versioduo/tee/hardware/tee.pdf

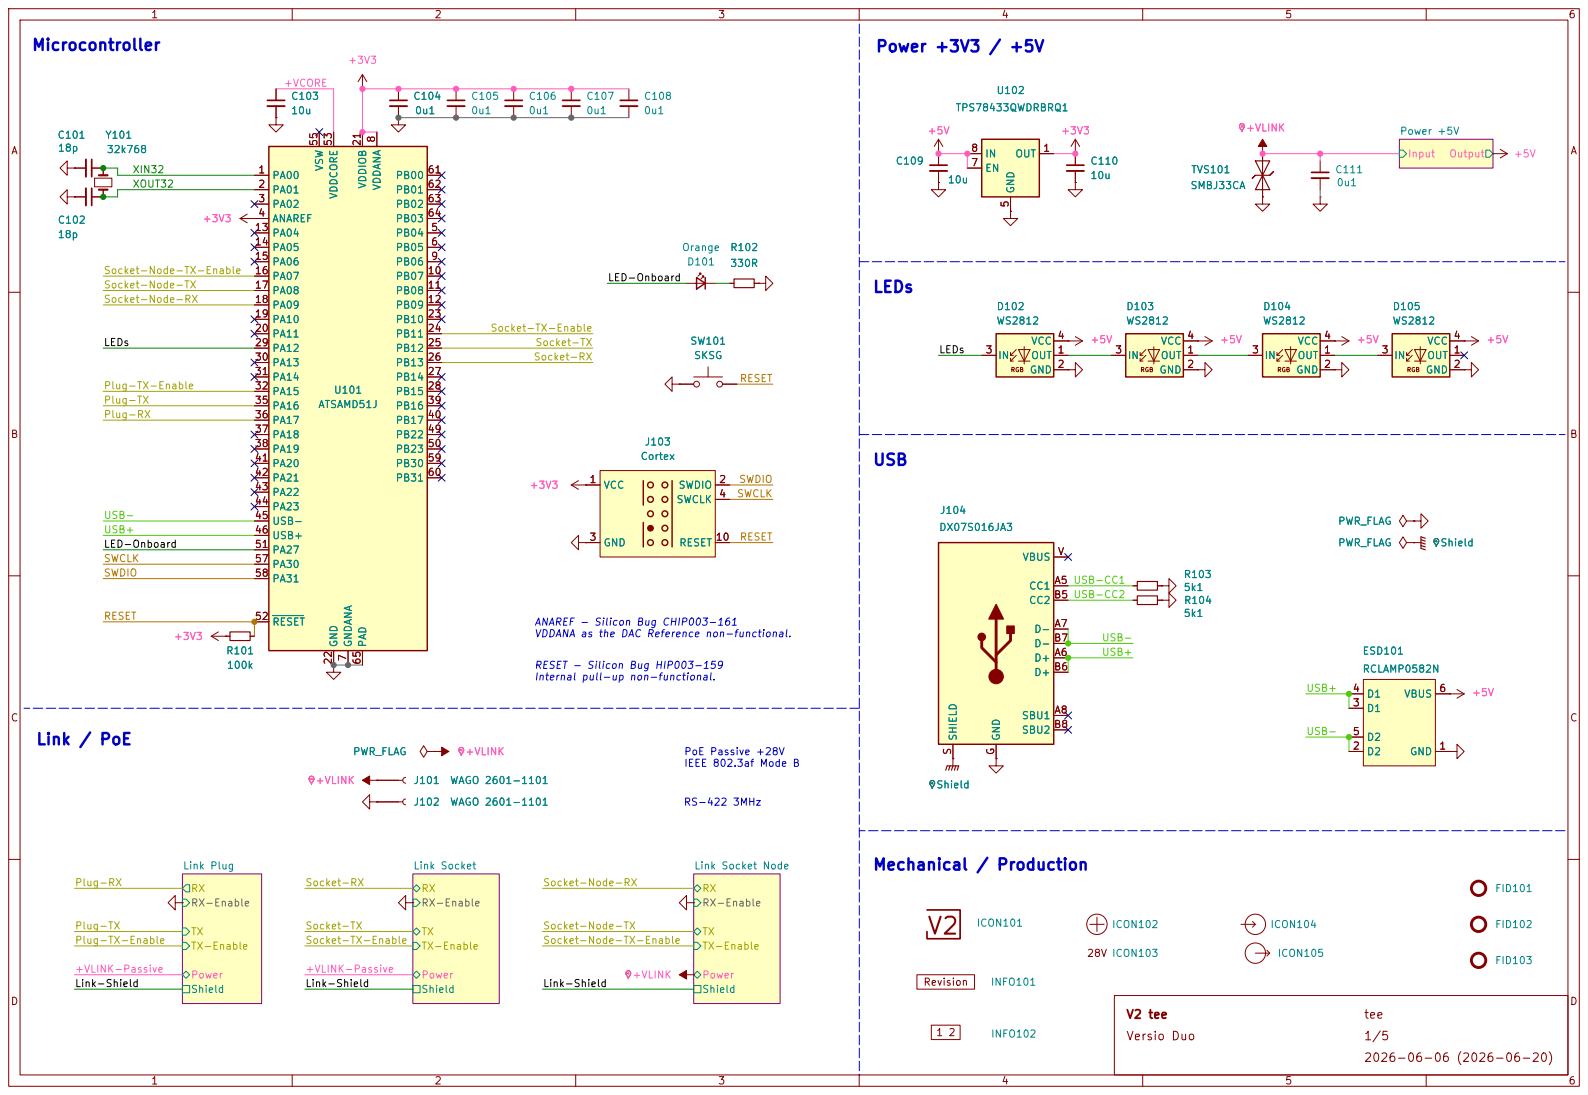
[picture p1: page 1]

Socket-Node-RX
LED-Onboard Plug-TX

LEDs Plug-TX-Enable
LEDs Plug-RX

Socket-Node-RX RESET SWDIO

ANAREF - Silicon Bug CHIP003-161
VDDANA as the DAC Reference non-functional. RESET - Silicon Bug HIP003-159

Internal pull-up non-functional. RS-422 3MHz PoE Passive +28V

TX-Enable Power Shield

Link-Shield +VLINK-Passive

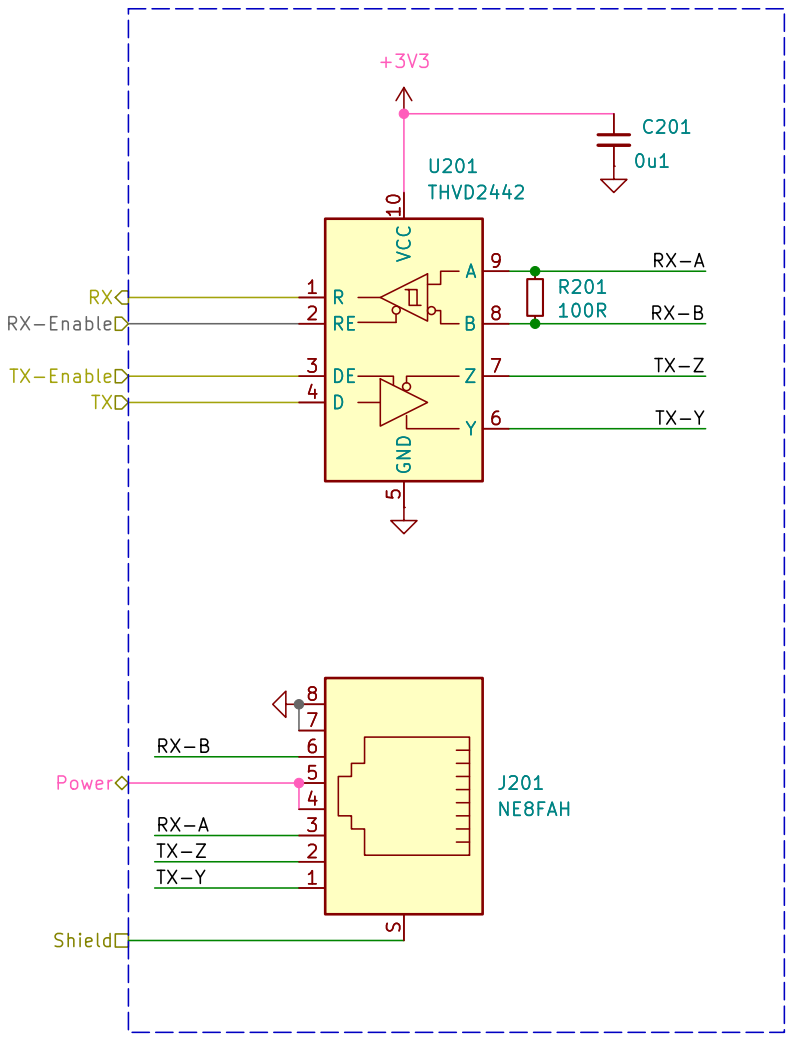
[picture p2: page 2]

0u1 RX-Enable Power TX-Enable RX

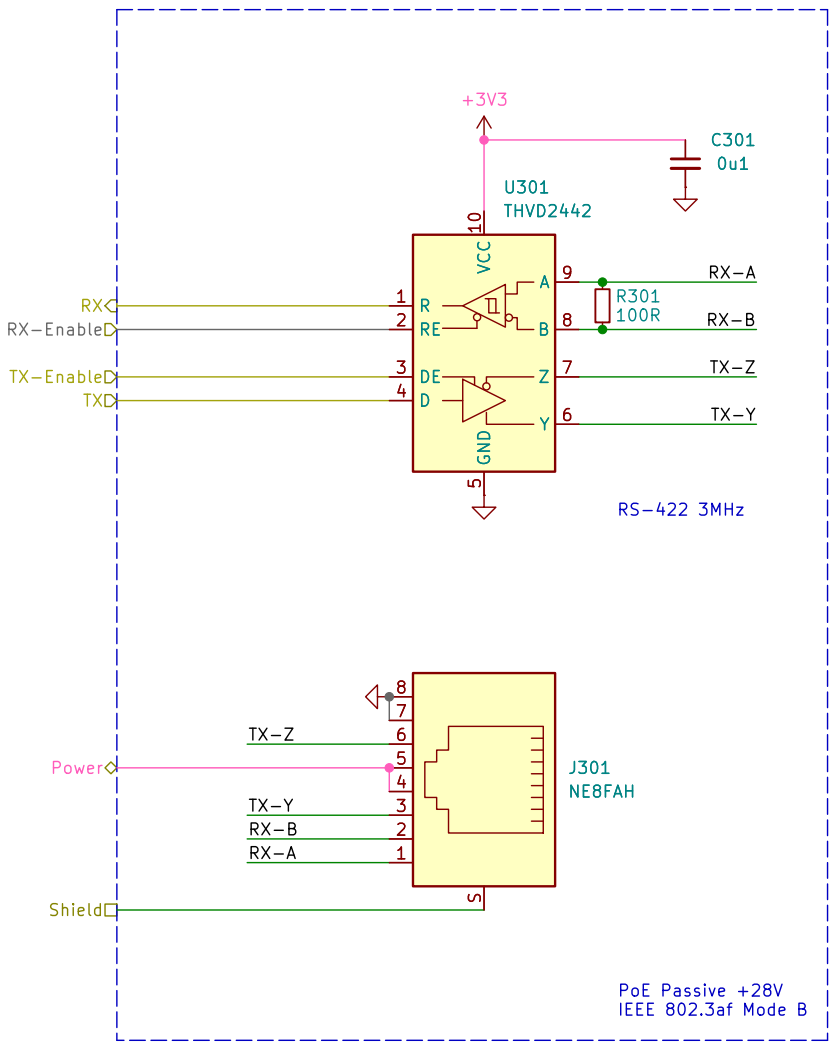
[picture p3: page 3]

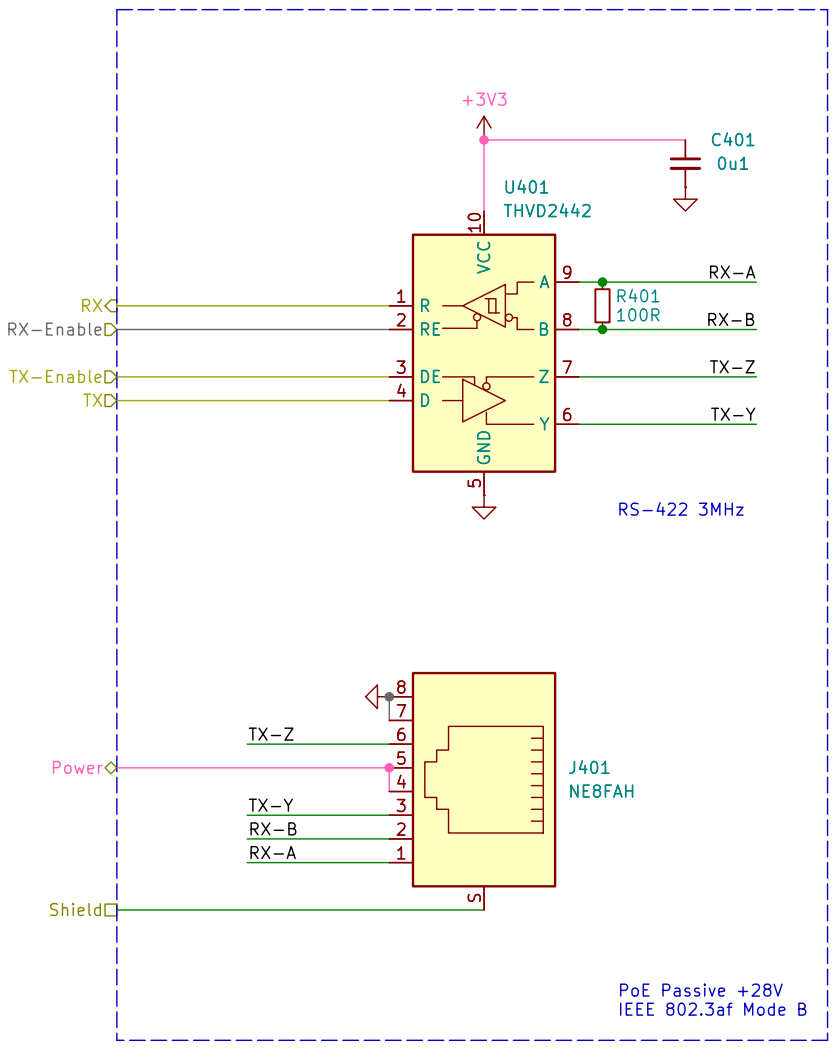
[picture p4: page 4]

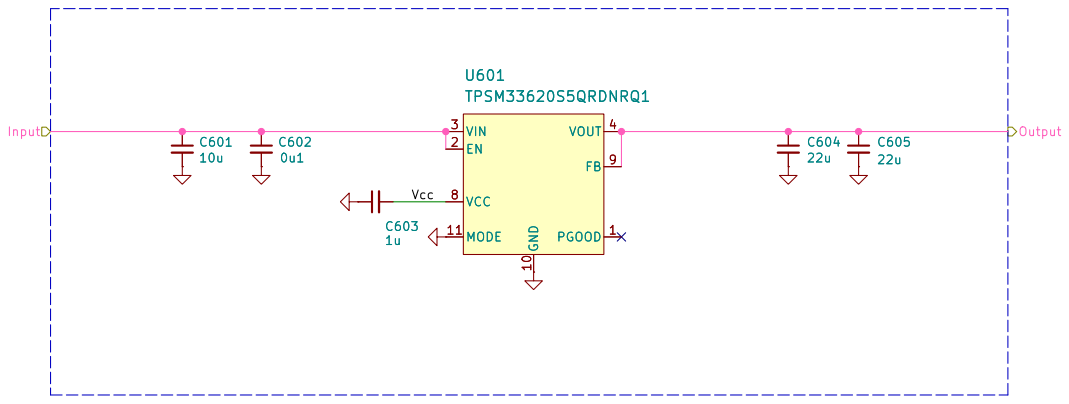
[picture p5: page 5]
