versioduo/tee/hardware/tee.kicad_pcb

## KiCad design hardware/tee.kicad_pcb (2026-07-12)

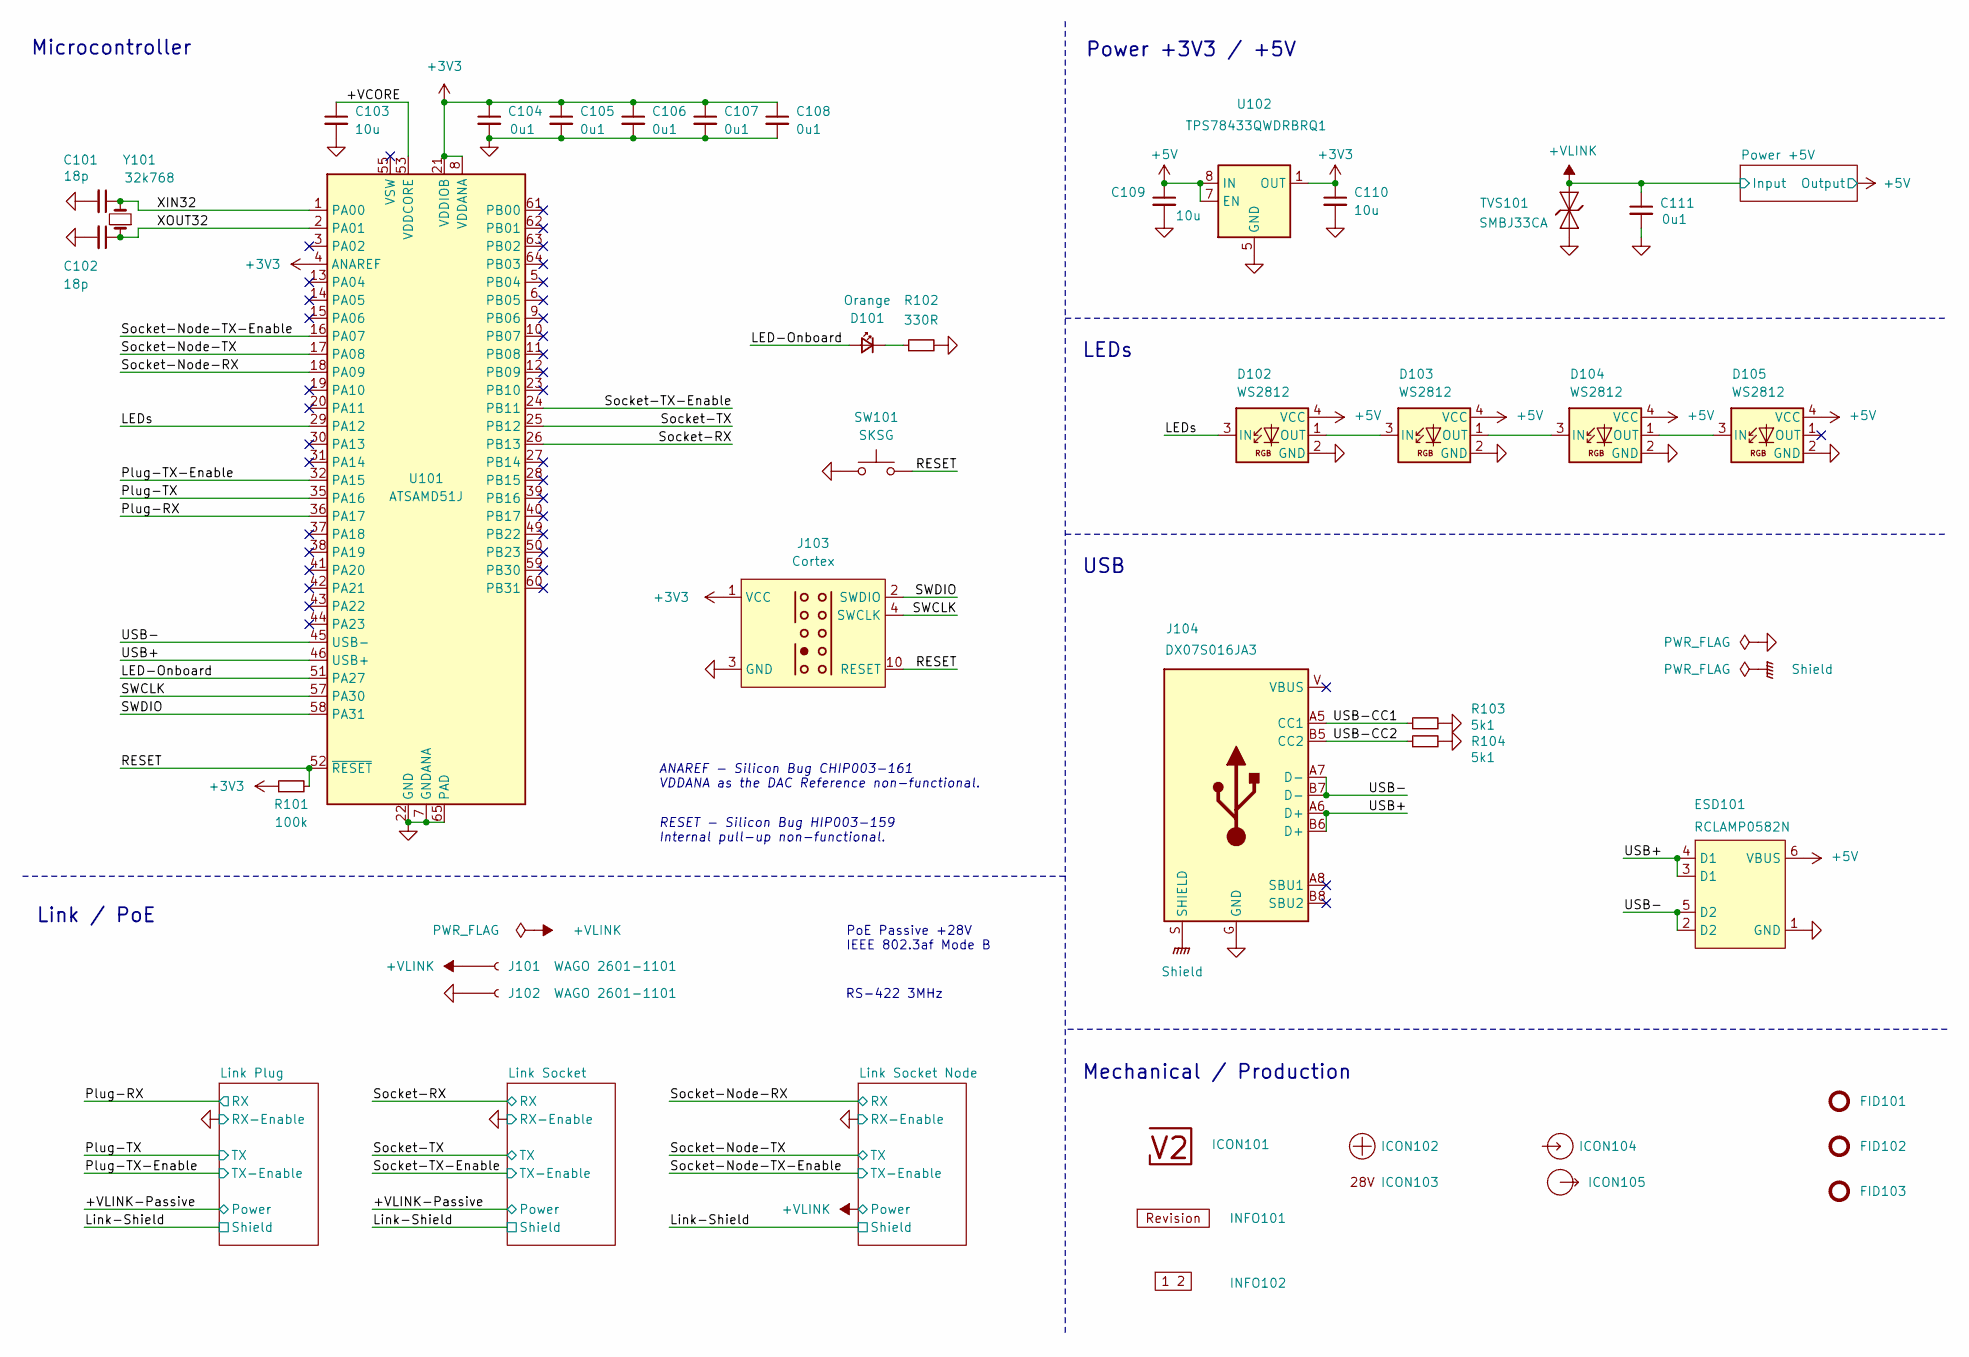
[picture p6: schematic tee.kicad_sch, V2 tee]

Parts:
C101, C102: 18p; C_1608; Rating 50V; Mouser 810-CGA3E2C0G1H180J
C103: 10u; C_1608; Rating 10V; Mouser 810-C1608X6S1A106M
C104, C105, C106, C107, C108, C111: 0u1; C_1608; Rating 50V; Mouser 810-CGA3E2X7R1H104MA
C109, C110: 10u; C_2012; Rating 25V; Mouser 810-C2012X5R1E106K
D101: Orange; LED_1608; Rating 605nm; Mouser 755-SML-D12D1WT86
D102, D103, D104, D105: WS2812; WS2812-2020; Rating 15mA; LCSC C965555
ESD101: RCLAMP0582N; SLP1210N6; Rating 20kV; Mouser 947-RCLAMP0582N.TCT
FID101, FID102, FID103: Fiducial_Paste; Fiducial_0.5mm_Mask1mm_Paste
ICON101: V2-logo; Logo_Small
ICON102: Plus; Plus_Small
ICON103: 28V
ICON104: Arrow_In
ICON105: Arrow_Out
INFO101: Revision
INFO102: Layer_Numbers-4
J101, J102: WAGO 2601-1101; 2601-1101; Rating 17.5A
J103: Cortex
J104: DX07S016JA3; JAE_DX07S016JA3; Rating USB2.0; Mouser 656-DX07S016JA3R1500
R101: 100k; R_1608; Rating 100mW; Mouser 71-CRCW0603100KFKEAC
R102: 330R; R_1608; Rating 100mW; Mouser 71-CRCW0603330RFKEAC
R103, R104: 5k1; R_1608; Rating 100mW; Mouser 71-CRCW06035K10FKEAC
SW101: SKSG; Rating 1.6N; Mouser 688-SKSGACE010
TVS101: SMBJ33CA; D_SMB; Rating 33V; Mouser 652-SMBJ33CA-Q
U101: ATSAMD51J; QFN-64-1EP_9x9mm_P0.5mm_EP4.8x4.8mm_ThermalVias; Rating Cortex-M4F; Mouser 556-ATSAMD51J19AMU
U102: TPS78433QWDRBRQ1; VSON-8-1_3x3mm_P0.65_EP1.65x2.4mm; Rating 300mA; Mouser 595-TPS78433QWDRBRQ1
Y101: 32k768; Crystal_SMD_3215-2Pin_3.2x1.5mm; Rating 10ppm; Mouser 815-ABS0716632.768KT

Connections:
+3V3: C104.1, C105.1, C106.1, C107.1, C108.1, C110.1, J103.1 (VCC), R101.1, U101.4 (ANAREF), U101.8 (VDDANA), U101.21 (VDDIOB), U101.34 (VDDIO), U101.48 (VDDIO), U101.56 (VDDIO), U102.1 (OUT); also elsewhere on the board
+5V: C109.1, D102.4 (VCC), D103.4 (VCC), D104.4 (VCC), D105.4 (VCC), ESD101.6 (VBUS), U102.7 (EN), U102.8 (IN); also elsewhere on the board
/+VCORE: C103.1, U101.53 (VDDCORE)
/+VLINK: C111.1, J101.1, TVS101.2 (A); also elsewhere on the board
/LED-Onboard: D101.2 (A), U101.51 (PA27)
/LEDs: D102.3 (IN), U101.29 (PA12)
/Plug-RX: U101.36 (PA17); also elsewhere on the board
/Plug-TX: U101.35 (PA16); also elsewhere on the board
/Plug-TX-Enable: U101.32 (PA15); also elsewhere on the board
/RESET: J103.10 (RESET), R101.2, SW101.2, U101.52 (~RESET)
/SWCLK: J103.4 (SWCLK), U101.57 (PA30)
/SWDIO: J103.2 (SWDIO), U101.58 (PA31)
/Shield: J104.S (SHIELD)
/Socket-Node-RX: U101.18 (PA09); also elsewhere on the board
/Socket-Node-TX: U101.17 (PA08); also elsewhere on the board
/Socket-Node-TX-Enable: U101.16 (PA07); also elsewhere on the board
/Socket-RX: U101.26 (PB13); also elsewhere on the board
/Socket-TX: U101.25 (PB12); also elsewhere on the board
/Socket-TX-Enable: U101.24 (PB11); also elsewhere on the board
/USB+: ESD101.3 (D1), ESD101.4 (D1), J104.A6 (D+), J104.B6 (D+), U101.46 (USB+)
/USB-: ESD101.2 (D2), ESD101.5 (D2), J104.A7 (D-), J104.B7 (D-), U101.45 (USB-)
/USB-CC1: J104.A5 (CC1), R103.1
/USB-CC2: J104.B5 (CC2), R104.1
/XIN32: C101.1, U101.1 (PA00), Y101.2
/XOUT32: C102.1, U101.2 (PA01), Y101.1
GND: C101.2, C102.2, C103.2, C104.2, C105.2, C106.2, C107.2, C108.2, C109.2, C110.2, C111.2, D102.2 (GND), D103.2 (GND), D104.2 (GND), D105.2 (GND), ESD101.1 (GND), J102.1, J103.3 (GND), J103.5 (GND), J104.G (GND), R102.2, R103.2, R104.2, SW101.1, TVS101.1 (K), U101.7 (GNDANA), U101.22 (GND), U101.33 (GND), U101.47 (GND), U101.54 (GND), U101.65 (PAD), U102.5 (GND), U102.9 (GND); also elsewhere on the board
unnamed: D101.1 (K), R102.1
unnamed: D102.1 (OUT), D103.3 (IN)
unnamed: D103.1 (OUT), D104.3 (IN)
unnamed: D104.1 (OUT), D105.3 (IN)

Notes on the sheet:
ANAREF - Silicon Bug CHIP003-161 VDDANA as the DAC Reference non-functional.
Link / PoE
RESET - Silicon Bug HIP003-159 Internal pull-up non-functional.
LEDs
Power +3V3 / +5V
Mechanical / Production
RS-422 3MHz
Microcontroller
PoE Passive +28V IEEE 802.3af Mode B
USB

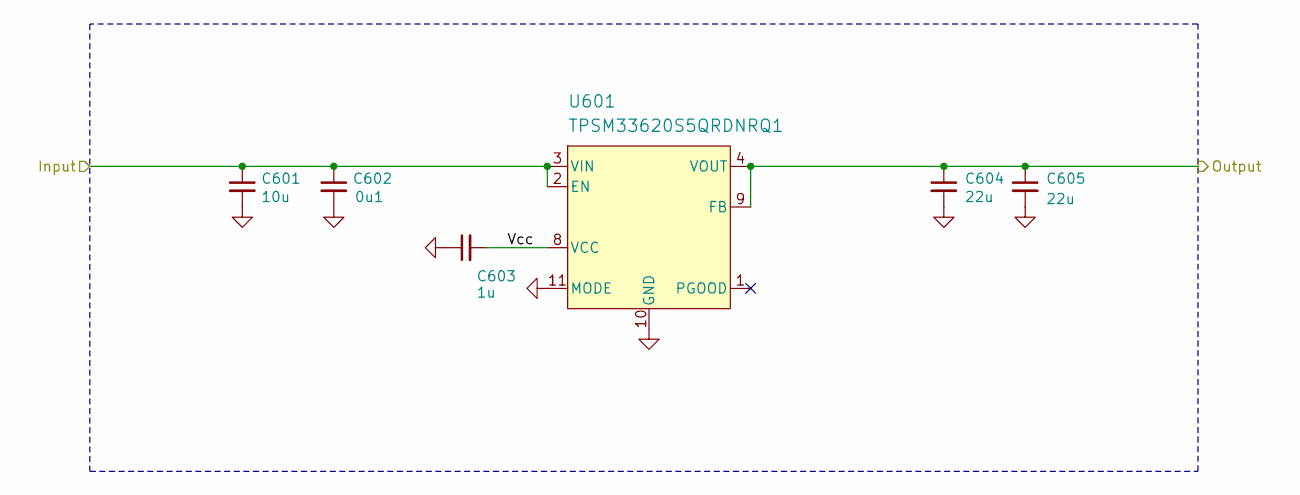
[picture p7: schematic PowerSupply.kicad_sch, V2 tee]

Parts:
C601: 10u; C_3225; Rating 50V; Mouser 810-CNC6P1X7R1H106K2
C602: 0u1; C_1608; Rating 50V; Mouser 810-CGA3E2X7R1H104MA
C603: 1u; C_1608; Rating 50V; Mouser 810-CGA3E3X7R1H105K0
C604, C605: 22u; C_3225; Rating 25V; Mouser 810-CGA6P3X7R1E226M5
U601: TPSM33620S5QRDNRQ1; QFN-11; Rating 2A; Mouser 595-SM33620S5QRDNRQ1

Connections:
+5V: C604.1, C605.1, U601.4 (VOUT), U601.9 (FB); also elsewhere on the board
/+VLINK: C601.1, C602.1, U601.2 (EN), U601.3 (VIN); also elsewhere on the board
/Power +5V/Vcc: C603.2, U601.8 (VCC)
GND: C601.2, C602.2, C603.1, C604.2, C605.2, U601.10 (GND), U601.11 (MODE); also elsewhere on the board

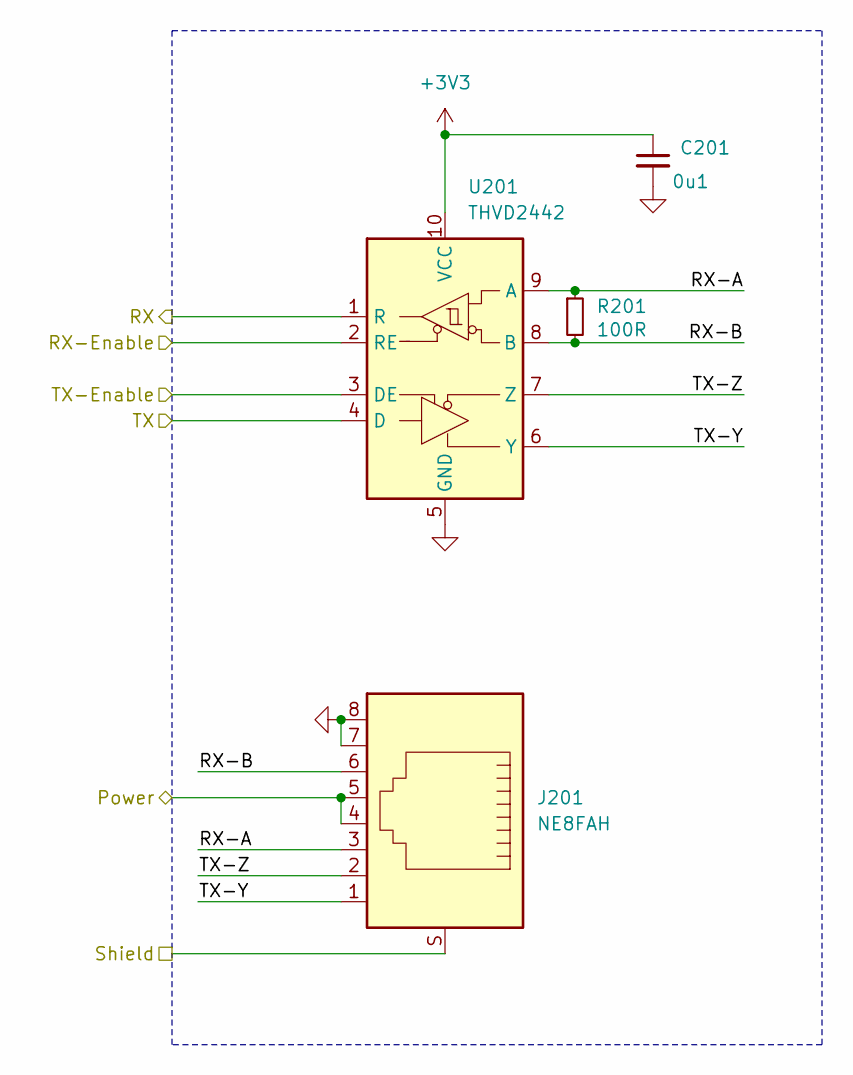
[picture p8: schematic LinkPlug.kicad_sch, V2 tee]

Parts:
C201: 0u1; C_1608; Rating 50V; Mouser 810-CGA3E2X7R1H104MA
J201: NE8FAH; Rating CAT5e; Mouser 568-NE8FAH
R201: 100R; R_1608; Rating 330mW; Mouser 71-CRCW0603100RFKEAH
U201: THVD2442; VSON-10-4-1EP_3x3mm_P0.5mm_EP1.65x2.4mm_ThermalVias; Rating 20Mbps; Mouser 595-THVD2442DRCR

Connections:
+3V3: C201.1, U201.10 (VCC); also elsewhere on the board
/+VLINK-Passive: J201.4, J201.5; also elsewhere on the board
/Link Plug/RX-A: J201.3, R201.1, U201.9 (A)
/Link Plug/RX-B: J201.6, R201.2, U201.8 (B)
/Link Plug/TX-Y: J201.1, U201.6 (Y)
/Link Plug/TX-Z: J201.2, U201.7 (Z)
/Link-Shield: J201.S; also elsewhere on the board
/Plug-RX: U201.1 (R); also elsewhere on the board
/Plug-TX: U201.4 (D); also elsewhere on the board
/Plug-TX-Enable: U201.3 (DE); also elsewhere on the board
GND: C201.2, J201.7, J201.8, U201.2 (RE), U201.5 (GND), U201.11 (GND); also elsewhere on the board

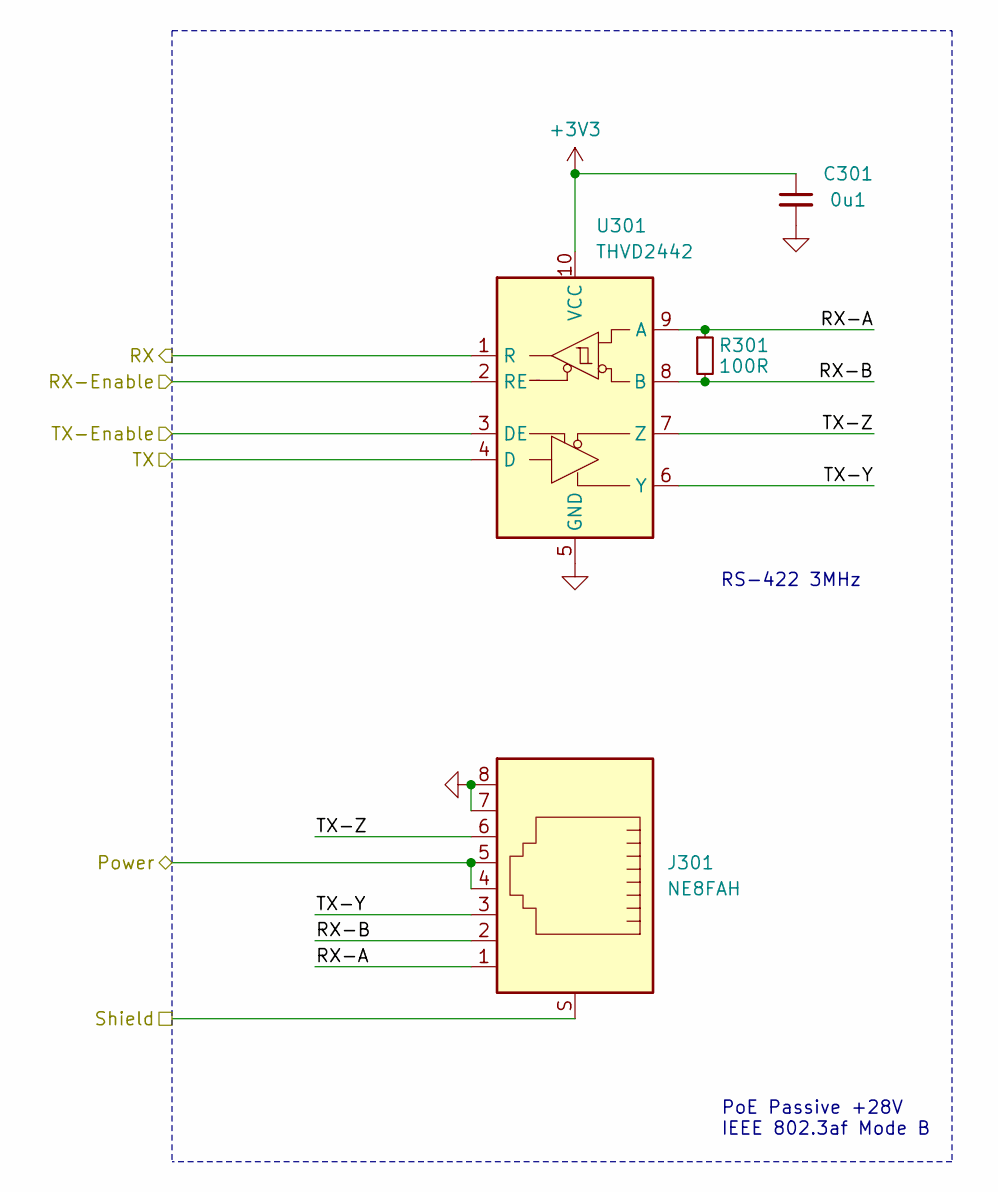
[picture p9: schematic LinkSocket.kicad_sch, V2 tee]

Parts:
C301: 0u1; C_1608; Rating 50V; Mouser 810-CGA3E2X7R1H104MA
J301: NE8FAH; Rating CAT5e; Mouser 568-NE8FAH
R301: 100R; R_1608; Rating 330mW; Mouser 71-CRCW0603100RFKEAH
U301: THVD2442; VSON-10-4-1EP_3x3mm_P0.5mm_EP1.65x2.4mm_ThermalVias; Rating 20Mbps; Mouser 595-THVD2442DRCR

Connections:
+3V3: C301.1, U301.10 (VCC); also elsewhere on the board
/+VLINK-Passive: J301.4, J301.5; also elsewhere on the board
/Link Socket/RX-A: J301.1, R301.1, U301.9 (A)
/Link Socket/RX-B: J301.2, R301.2, U301.8 (B)
/Link Socket/TX-Y: J301.3, U301.6 (Y)
/Link Socket/TX-Z: J301.6, U301.7 (Z)
/Link-Shield: J301.S; also elsewhere on the board
/Socket-RX: U301.1 (R); also elsewhere on the board
/Socket-TX: U301.4 (D); also elsewhere on the board
/Socket-TX-Enable: U301.3 (DE); also elsewhere on the board
GND: C301.2, J301.7, J301.8, U301.2 (RE), U301.5 (GND), U301.11 (GND); also elsewhere on the board

Parts of its further copies:
C401: 0u1; C_1608; Rating 50V; Mouser 810-CGA3E2X7R1H104MA
J401: NE8FAH; Rating CAT5e; Mouser 568-NE8FAH
R401: 100R; R_1608; Rating 330mW; Mouser 71-CRCW0603100RFKEAH
U401: THVD2442; VSON-10-4-1EP_3x3mm_P0.5mm_EP1.65x2.4mm_ThermalVias; Rating 20Mbps; Mouser 595-THVD2442DRCR

Connections of its further copies:
+3V3: C401.1, U401.10 (VCC); also elsewhere on the board
/+VLINK: J401.4, J401.5; also elsewhere on the board
/Link Socket Node/RX-A: J401.1, R401.1, U401.9 (A)
/Link Socket Node/RX-B: J401.2, R401.2, U401.8 (B)
/Link Socket Node/TX-Y: J401.3, U401.6 (Y)
/Link Socket Node/TX-Z: J401.6, U401.7 (Z)
/Link-Shield: J401.S; also elsewhere on the board
/Socket-Node-RX: U401.1 (R); also elsewhere on the board
/Socket-Node-TX: U401.4 (D); also elsewhere on the board
/Socket-Node-TX-Enable: U401.3 (DE); also elsewhere on the board
GND: C401.2, J401.7, J401.8, U401.2 (RE), U401.5 (GND), U401.11 (GND); also elsewhere on the board

Notes on the sheet:
PoE Passive +28V IEEE 802.3af Mode B
RS-422 3MHz

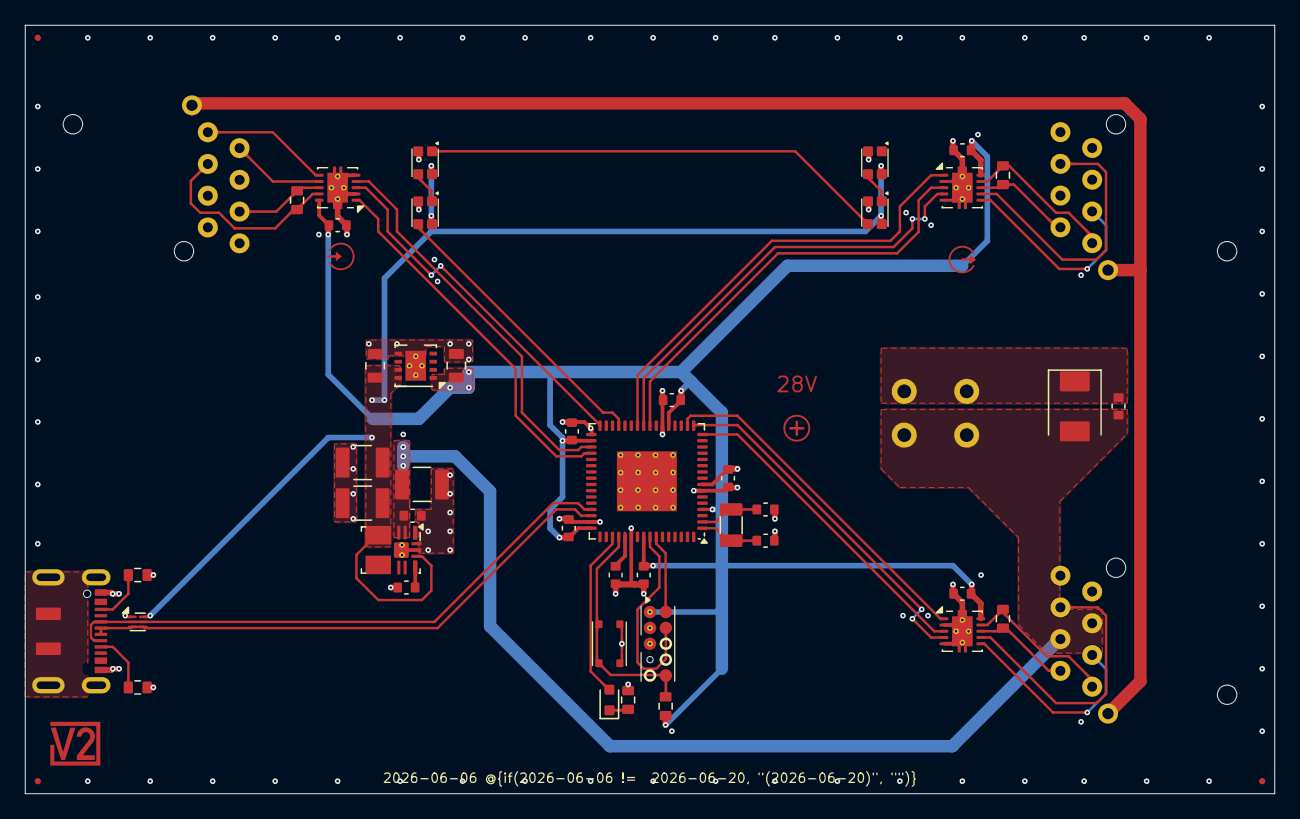
[picture p10: board tee.kicad_pcb from above]

Board: 4 copper layers, 100.0 x 61.5 mm, 58 parts (0 on the bottom side), 44 nets.
